Vtechcode/ESP32S3_A7672S/Images/schematic_a7672s.jpg

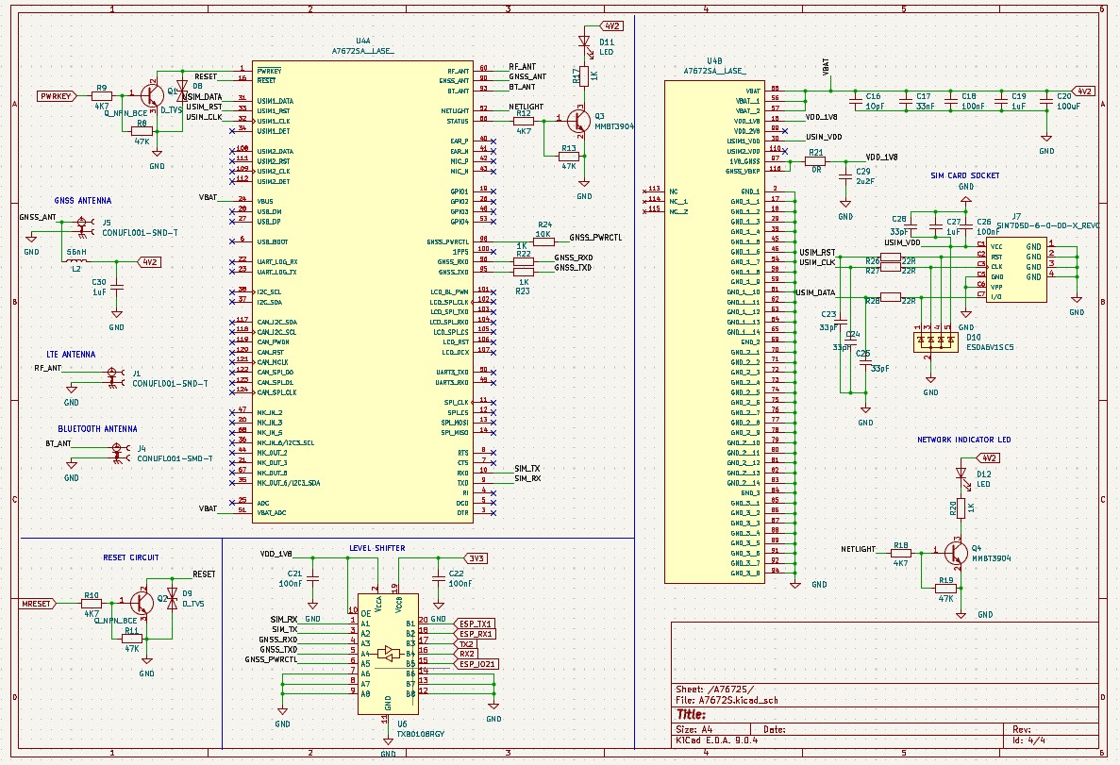
Images/schematic_a7672s.jpg
