Vtechcode/ESP32S3_A7672S/Images/schematic_esp32s3.jpg

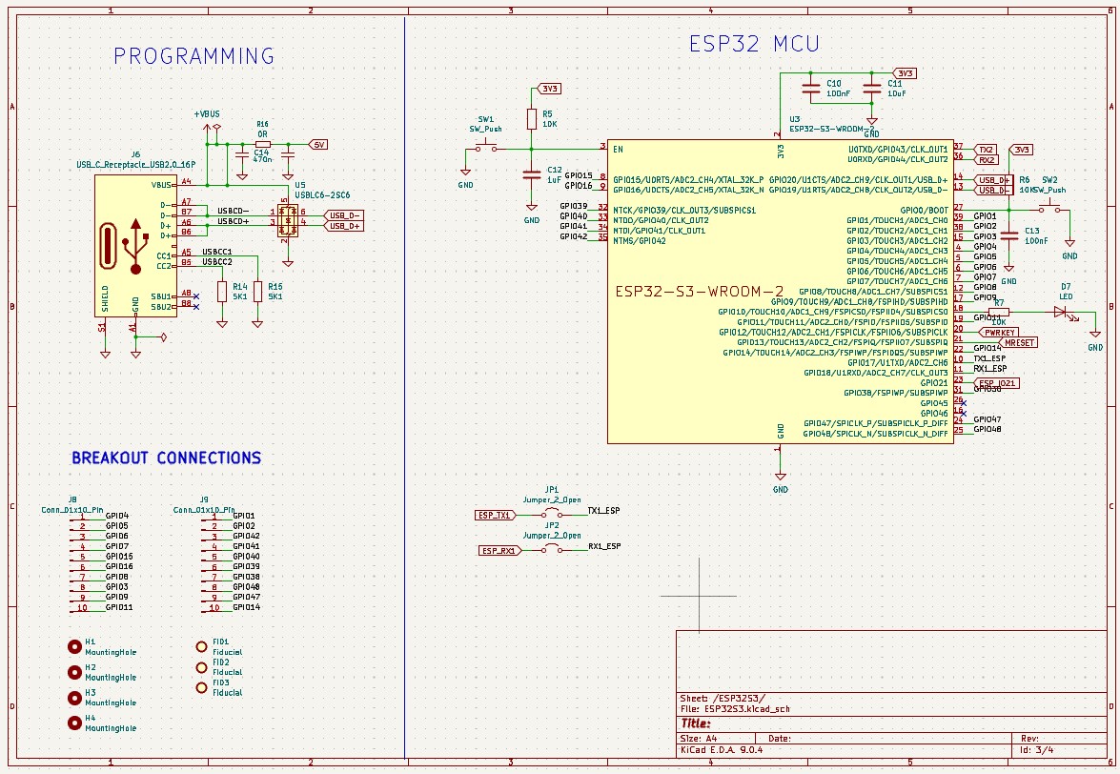
Images/schematic_esp32s3.jpg
