Vtechcode/ESP32S3_A7672S/Images/3d2.jpg

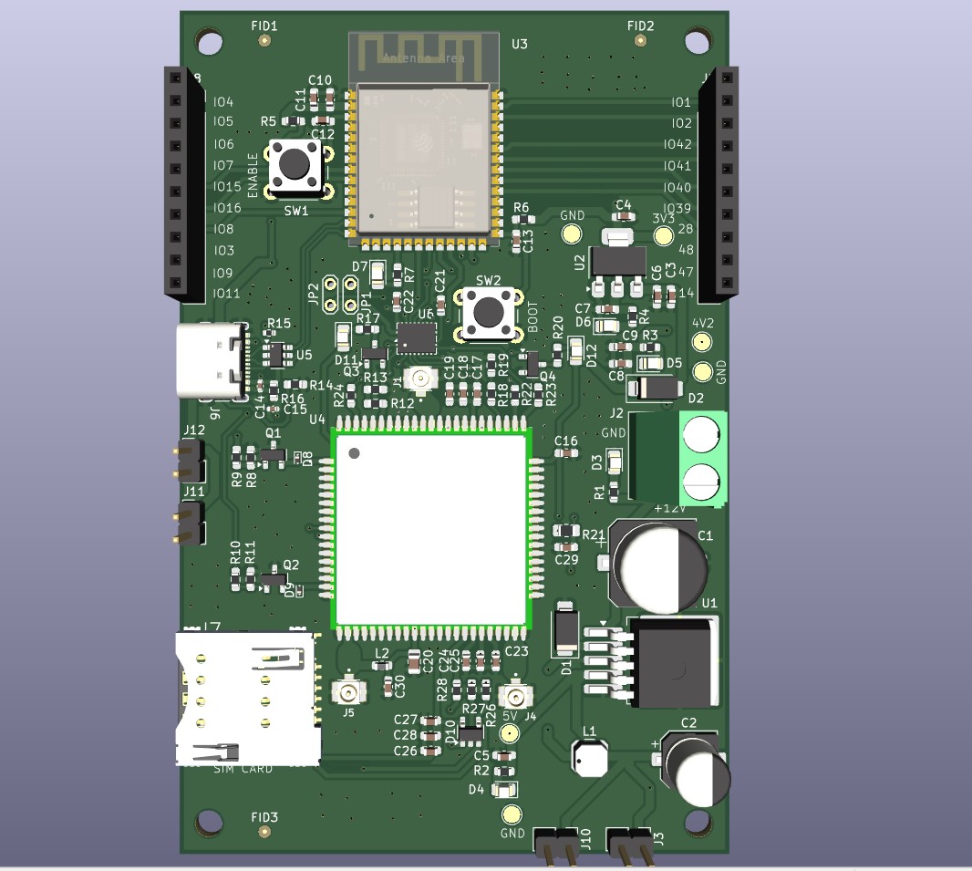
Images/3d2.jpg
