Vtechcode/ESP32S3_A7672S/Images/3d3.jpg

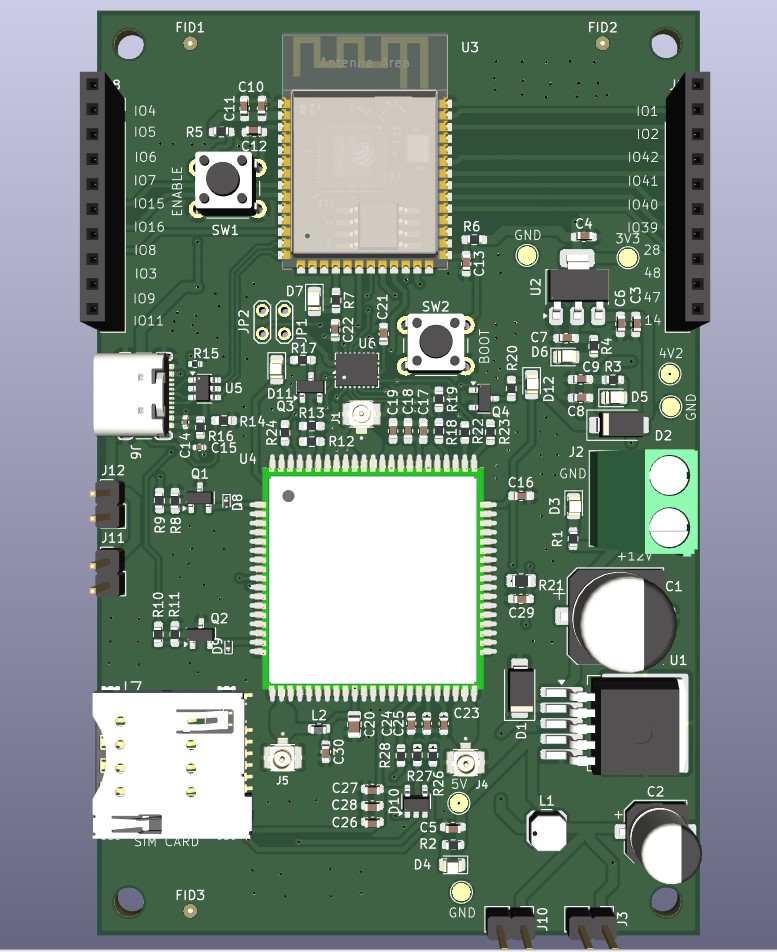
Images/3d3.jpg
