Vtechcode/ESP32S3_A7672S/Images/3D.jpg

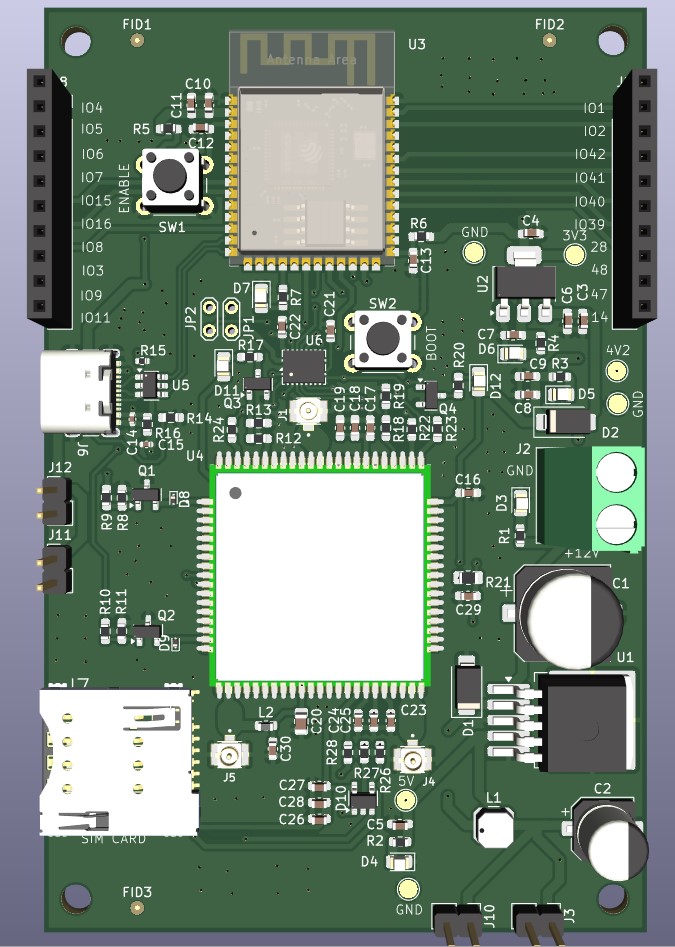
Images/3D.jpg
