Vtechcode/ESP32S3_A7672S/Images/layout.jpg

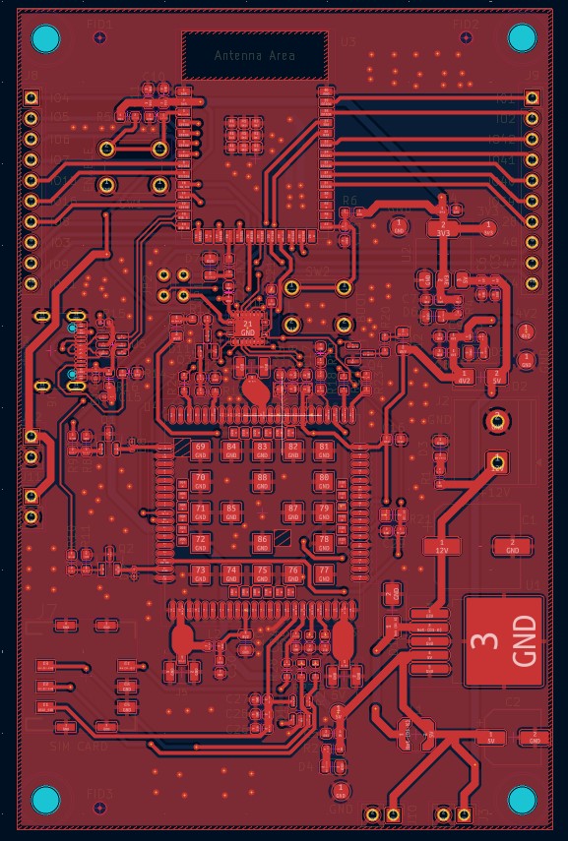
Images/layout.jpg
