Vtechcode/ESP32S3_A7672S/Images/schematic_power.jpg

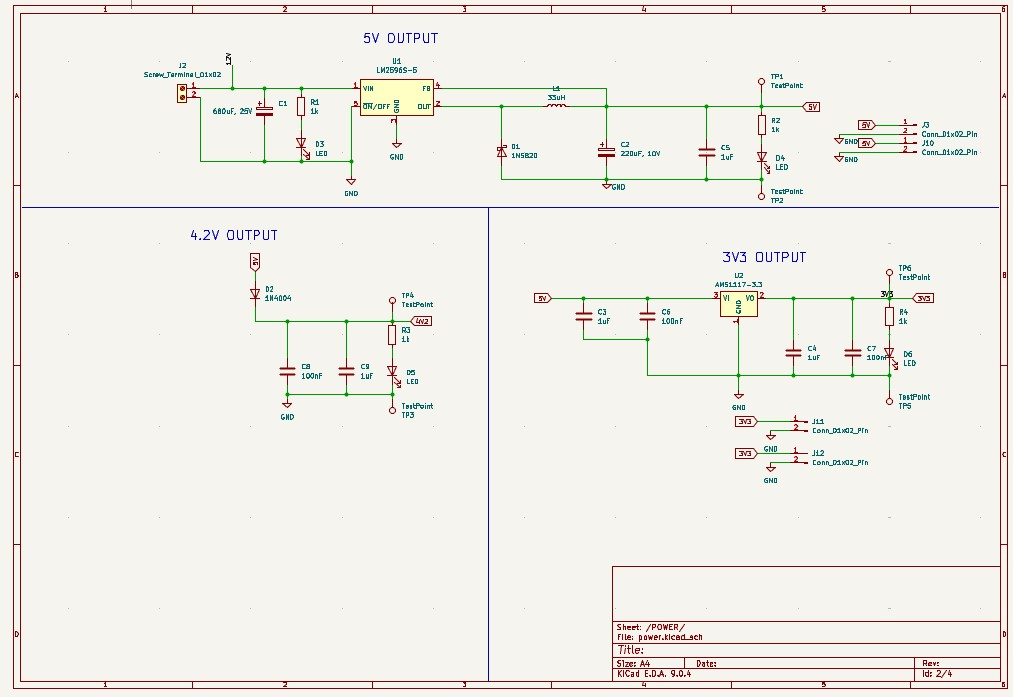
Images/schematic_power.jpg
