Vtechcode/ESP32S3_A7672S/manufacturing_files/ESP32S3-A7672S.csv

Reference | Qty | Value | DNP | Exclude from BOM | Exclude from Board | Footprint | Datasheet | Check_prices | Distributer | LCSC number | Availability
C1 | 1 | 680uF, 25V |  |  |  | Capacitor_SMD:CP_Elec_10x7.7 | ~ |  | https://www.digikey.com/en/products/detail/panasonic-industry/EEE-FN1E681UP/11657034 | C494831
C2 | 1 | 220uF, 10V |  |  |  | Capacitor_SMD:CP_Elec_6.3x7.7 | ~ |  | https://www.digikey.com/en/products/detail/panasonic-industry/EEE-1AA221XP/766038 | C336207
C3,C4,C5,C9,C12,C19 | 6 | 1uF |  |  |  | Capacitor_SMD:C_0603_1608Metric_Pad1.08x0.95mm_HandSolder | ~ |  | https://www.digikey.com/en/products/detail/samsung-electro-mechanics/CL10B105KA8NNNC/3886842 | C29936
C6,C7,C8,C10,C13,C18 | 6 | 100nF |  |  |  | Capacitor_SMD:C_0603_1608Metric_Pad1.08x0.95mm_HandSolder | ~ |  | https://www.digikey.com/en/products/detail/samsung-electro-mechanics/CL10E104KC8VPNC/20498486 | C16194197
C11 | 1 | 10uF |  |  |  | Capacitor_SMD:C_0603_1608Metric_Pad1.08x0.95mm_HandSolder | ~ |  | https://www.digikey.com/en/products/detail/murata-electronics/GRM188R6YA106MA73D/5877411 | C194427
C14,C15 | 2 | 470n |  |  |  | Capacitor_SMD:C_0402_1005Metric | ~ |  | https://eu.mouser.com/ProductDetail/Samsung-Electro-Mechanics/CL05A474KQ5NNND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 | C364319
C16 | 1 | 10pF |  |  |  | Capacitor_SMD:C_0603_1608Metric_Pad1.08x0.95mm_HandSolder | ~ |  | https://www.digikey.com/en/products/detail/kemet/C0603C100J5GACTU/411051 | C2167326
C17 | 1 | 33nF |  |  |  | Capacitor_SMD:C_0603_1608Metric_Pad1.08x0.95mm_HandSolder | ~ |  | https://www.digikey.com/en/products/detail/samsung-electro-mechanics/CL10B333KC8WPNC/20498521 | C16194260
C20 | 1 | 100uF |  |  |  | Capacitor_SMD:C_0805_2012Metric | ~ |  | https://www.digikey.com/en/products/detail/murata-electronics/GRM21BR60J107ME15L/6155751 | C141660
C21,C22,C26 | 3 | 100nF |  |  |  | Capacitor_SMD:C_0603_1608Metric | ~ |  | https://www.digikey.com/en/products/detail/samsung-electro-mechanics/CL10E104KC8VPNC/20498486 | C16194197
C23,C24,C25,C28 | 4 | 33pF |  |  |  | Capacitor_SMD:C_0603_1608Metric | ~ |  | https://www.digikey.com/en/products/detail/samsung-electro-mechanics/CL10C330JB8NNNC/3886728 | C1663
C27,C30 | 2 | 1uF |  |  |  | Capacitor_SMD:C_0603_1608Metric | ~ |  | https://www.digikey.com/en/products/detail/samsung-electro-mechanics/CL10B105KA8NNNC/3886842 | C29936
C29 | 1 | 2u2F |  |  |  | Capacitor_SMD:C_0603_1608Metric_Pad1.08x0.95mm_HandSolder | ~ |  | https://www.digikey.com/en/products/detail/samsung-electro-mechanics/CL10A225KO8NNNC/3886698 | C23630
D1 | 1 | 1N5820 |  |  |  | Diode_SMD:D_SMA | http://www.vishay.com/docs/88526/1n5820.pdf |  | https://eu.mouser.com/ProductDetail/Microchip-Technology/1N5820?qs=w%2Fv1CP2dgqqgWjSAo9oFwA%3D%3D | C95400
D2 | 1 | 1N4004 |  |  |  | Diode_SMD:D_SMA | http://www.vishay.com/docs/88503/1n4001.pdf |  | https://eu.mouser.com/ProductDetail/Rectron/FM4004-W?qs=Iw9Ubr57Px3IHNH1bE4l9w%3D%3D | C727080
D3,D4,D5,D6 | 4 | LED |  |  |  | LED_SMD:LED_0805_2012Metric | ~ |  | https://www.digikey.com/en/products/detail/kingbright/APT2012SURCK/1747532 | C5875730
D7,D11,D12 | 3 | LED |  |  |  | LED_SMD:LED_0805_2012Metric_Pad1.15x1.40mm_HandSolder | ~ |  | https://www.digikey.com/en/products/detail/kingbright/APT2012LVBC-D/5177439 | C5879383
D8,D9 | 2 | D_TVS |  |  |  | Diode_SMD:D_SOD-923 | ~ |  | https://www.digikey.com/en/products/detail/onsemi/ESD9X5-0ST5G/1476616 | C87910
D10 | 1 | ESDA6V1SC5 |  |  |  | Package_TO_SOT_SMD:SOT-23-5 | https://www.st.com/resource/en/datasheet/esda5v3sc6.pdf |  | https://www.digikey.com/en/products/detail/stmicroelectronics/ESDA6V1SC5/1037990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 | C2935146
FID1,FID2,FID3 | 3 | Fiducial |  | Excluded from BOM |  | Fiducial:Fiducial_0.5mm_Mask1.5mm | ~
H1,H2,H3,H4 | 4 | MountingHole |  | Excluded from BOM |  | MountingHole:MountingHole_3.2mm_M3 | ~
J1,J4,J5 | 3 | CONUFL001-SMD-T |  |  |  | UFL:LINX_CONUFL001-SMD-T |  | https://www.snapeda.com/parts/CONUFL001-SMD/TE+Connectivity/view-part/?ref=eda | https://www.digikey.com/en/products/detail/te-connectivity-linx/CONUFL001-SMD-T/7427732 | C22418213 | In Stock
J2 | 1 | Screw_Terminal_01x02 |  |  |  | TerminalBlock_Phoenix:TerminalBlock_Phoenix_MKDS-1,5-2-5.08_1x02_P5.08mm_Horizontal | ~ |  |  | C5183929
J3,J10,J11,J12 | 4 | Conn_01x02_Pin |  | Excluded from BOM |  | Connector_PinHeader_2.54mm:PinHeader_1x02_P2.54mm_Vertical | ~
J6 | 1 | USB_C_Receptacle_USB2.0_16P |  |  |  | Connector_USB:USB_C_Receptacle_GCT_USB4105-xx-A_16P_TopMnt_Horizontal | https://www.usb.org/sites/default/files/documents/usb_type-c.zip |  | https://www.digikey.com/en/products/detail/same-sky-formerly-cui-devices/UJ20-C-H-G-SMT-1-P16-TR/24818576 | C45082766
J7 | 1 | SIM7050-6-0-00-X_REVC |  |  |  | sim7050:GCT_SIM7050-6-0-00-X_REVC |  | https://www.snapeda.com/parts/SIM7050-6-0-00-A/Global+Connector+Technology/view-part/?ref=eda | https://www.digikey.com/en/products/detail/gct/SIM7050-6-0-00-A/9859623 | C7363806 | In Stock
J8,J9 | 2 | Conn_01x10_Pin |  | Excluded from BOM |  | Connector_PinSocket_2.54mm:PinSocket_1x10_P2.54mm_Vertical | ~
JP1,JP2 | 2 | Jumper_2_Open |  | Excluded from BOM |  | TestPoint:TestPoint_2Pads_Pitch2.54mm_Drill0.8mm | ~
L1 | 1 | 33uH |  |  |  | Inductor_SMD:L_Coilcraft_LPS4018 | ~ |  | https://eu.mouser.com/en/ProductDetail/Coilcraft/LPS4018-333MRC?qs=QQJxVsr8EGZpg9FhYnz6eA%3D%3D | C5350136
L2 | 1 | 56nH |  |  |  | Inductor_SMD:L_0603_1608Metric | ~ |  | https://www.digikey.com/en/products/detail/bourns-inc/CE0603M-56NH/28968971 | C98079
Q1,Q2 | 2 | Q_NPN_BCE |  |  |  | Package_TO_SOT_SMD:SOT-23 | ~ |  | https://www.digikey.com/en/products/detail/onsemi/BC847CLT3G/1476015 | C513268
Q3,Q4 | 2 | MMBT3904 |  |  |  | Package_TO_SOT_SMD:SOT-23 | https://www.onsemi.com/pdf/datasheet/pzt3904-d.pdf |  | https://www.digikey.com/en/products/detail/onsemi/MMBT3904LT1G/919601 | C81464
R1,R2,R3,R4 | 4 | 1k |  |  |  | Resistor_SMD:R_0603_1608Metric | ~ |  | https://eu.mouser.com/ProductDetail/YAGEO/RT0603BRC071KL?qs=FVx2PiaBrRX2drlDnD5t4A%3D%3D | C860716
R5,R6,R7,R24 | 4 | 10K |  |  |  | Resistor_SMD:R_0603_1608Metric_Pad0.98x0.95mm_HandSolder | ~ |  | https://www.digikey.com/en/products/detail/stackpole-electronics-inc/RMCF0603FT10K0/1761235 | C2479067
R8,R11,R13,R19 | 4 | 47K |  |  |  | Resistor_SMD:R_0603_1608Metric_Pad0.98x0.95mm_HandSolder | ~ |  | https://www.digikey.com/en/products/detail/yageo/RC0603FR-0747KL/727253 | C105579
R9,R10,R12,R18 | 4 | 4K7 |  |  |  | Resistor_SMD:R_0603_1608Metric_Pad0.98x0.95mm_HandSolder | ~ |  | https://www.digikey.com/en/products/detail/yageo/RC0603FR-074K7L/727212 | C99782
R14 | 1 | 5K1 |  |  |  | Resistor_SMD:R_0603_1608Metric_Pad0.98x0.95mm_HandSolder | ~ |  | https://www.digikey.com/en/products/detail/panasonic-industry/ERJ-3EKF5101V/1746427 | C123727
R15 | 1 | 5K1 |  |  |  | Resistor_SMD:R_0402_1005Metric | ~ |  | https://www.digikey.com/en/products/detail/panasonic-industry/ERJ-3EKF5101V/1746427 | C123727
R16 | 1 | 0R |  |  |  | Resistor_SMD:R_0603_1608Metric | ~ |  | https://eu.mouser.com/ProductDetail/YAGEO/RC0603FR-070RL?qs=0yPvnVz5%2FmpDQv43TwvCfw%3D%3D | C100044
R17,R20,R23 | 3 | 1K |  |  |  | Resistor_SMD:R_0603_1608Metric_Pad0.98x0.95mm_HandSolder | ~ |  | https://eu.mouser.com/ProductDetail/YAGEO/RT0603BRC071KL?qs=FVx2PiaBrRX2drlDnD5t4A%3D%3D | C860716
R21 | 1 | 0R |  |  |  | Resistor_SMD:R_0805_2012Metric_Pad1.20x1.40mm_HandSolder | ~ |  | https://www.digikey.com/en/products/detail/yageo/RC0805FR-070RL/2827620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 | C100045
R22 | 1 | 1K |  |  |  | Resistor_SMD:R_0603_1608Metric | ~ |  | https://www.digikey.com/en/products/detail/bourns-inc/CE0603M-56NH/28968971 | C98079
R26,R27,R28 | 3 | 22R |  |  |  | Resistor_SMD:R_0603_1608Metric | ~ |  | https://www.digikey.com/en/products/detail/stackpole-electronics-inc/RMCF0603FT22R0/1760726 | C2479410
SW1,SW2 | 2 | SW_Push |  |  |  | Button_Switch_THT:SW_PUSH_6mm | ~ |  | https://www.digikey.com/en/products/detail/te-connectivity-alcoswitch-switches/1825910-6/1632536 | C428628
TP1,TP2,TP3,TP4,TP5,TP6 | 6 | TestPoint |  |  |  | TestPoint:TestPoint_Pad_D2.0mm | ~
U1 | 1 | LM2596S-5 |  |  |  | Package_TO_SOT_SMD:TO-263-5_TabPin3 | http://www.ti.com/lit/ds/symlink/lm2596.pdf |  | https://eu.mouser.com/ProductDetail/Texas-Instruments/LM2596S-5.0-NOPB?qs=X1J7HmVL2ZHVjCOmW%252BYINA%3D%3D | C116713
U2 | 1 | AMS1117-3.3 |  |  |  | Package_TO_SOT_SMD:SOT-223-3_TabPin2 | http://www.advanced-monolithic.com/pdf/ds1117.pdf |  | https://eu.mouser.com/ProductDetail/Texas-Instruments/LM1117MPX-3.3-NOPB?qs=X1J7HmVL2ZHRbBIxXi4utg%3D%3D | C9662
U3 | 1 | ESP32-S3-WROOM-2 |  |  |  | PCM_Espressif:ESP32-S3-WROOM-2 | https://www.espressif.com/sites/default/files/documentation/esp32-s3-wroom-2_datasheet_en.pdf |  | https://eu.mouser.com/en/ProductDetail/Espressif-Systems/ESP32-S3-WROOM-2-N32R16V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 | C42417293
U4 | 1 | A7672SA__LASE_ |  |  |  | A7672s:XCVR_A7672SA__LASE_ |  |  | https://www.digikey.com/en/products/detail/simcom-wireless-solutions-limited/A7672E-FASE/15841437 | C5370391
U5 | 1 | USBLC6-2SC6 |  |  |  | Package_TO_SOT_SMD:SOT-23-6 | https://www.st.com/resource/en/datasheet/usblc6-2.pdf |  | https://eu.mouser.com/ProductDetail/STMicroelectronics/USBLC6-2SC6?qs=po45yt2pPpu%2FhNIlwQdTlg%3D%3D | C7519
U6 | 1 | TXB0108RGY |  |  |  | Package_DFN_QFN:Texas_RGY_R-PVQFN-N20_EP2.05x3.05mm | http://www.ti.com/lit/ds/symlink/txb0108.pdf |  | https://eu.mouser.com/en/ProductDetail/Texas-Instruments/TXB0108RGYR?qs=oFXvjAmG9EjlwpBG6jCg6w%3D%3D | C194701
