Vtechcode/ESP32S3_A7672S/ESP32S3-A7672S/ESP32S3-A7672S.kicad_pcb

## KiCad design ESP32S3-A7672S/ESP32S3-A7672S.kicad_pcb (2026-09-28)

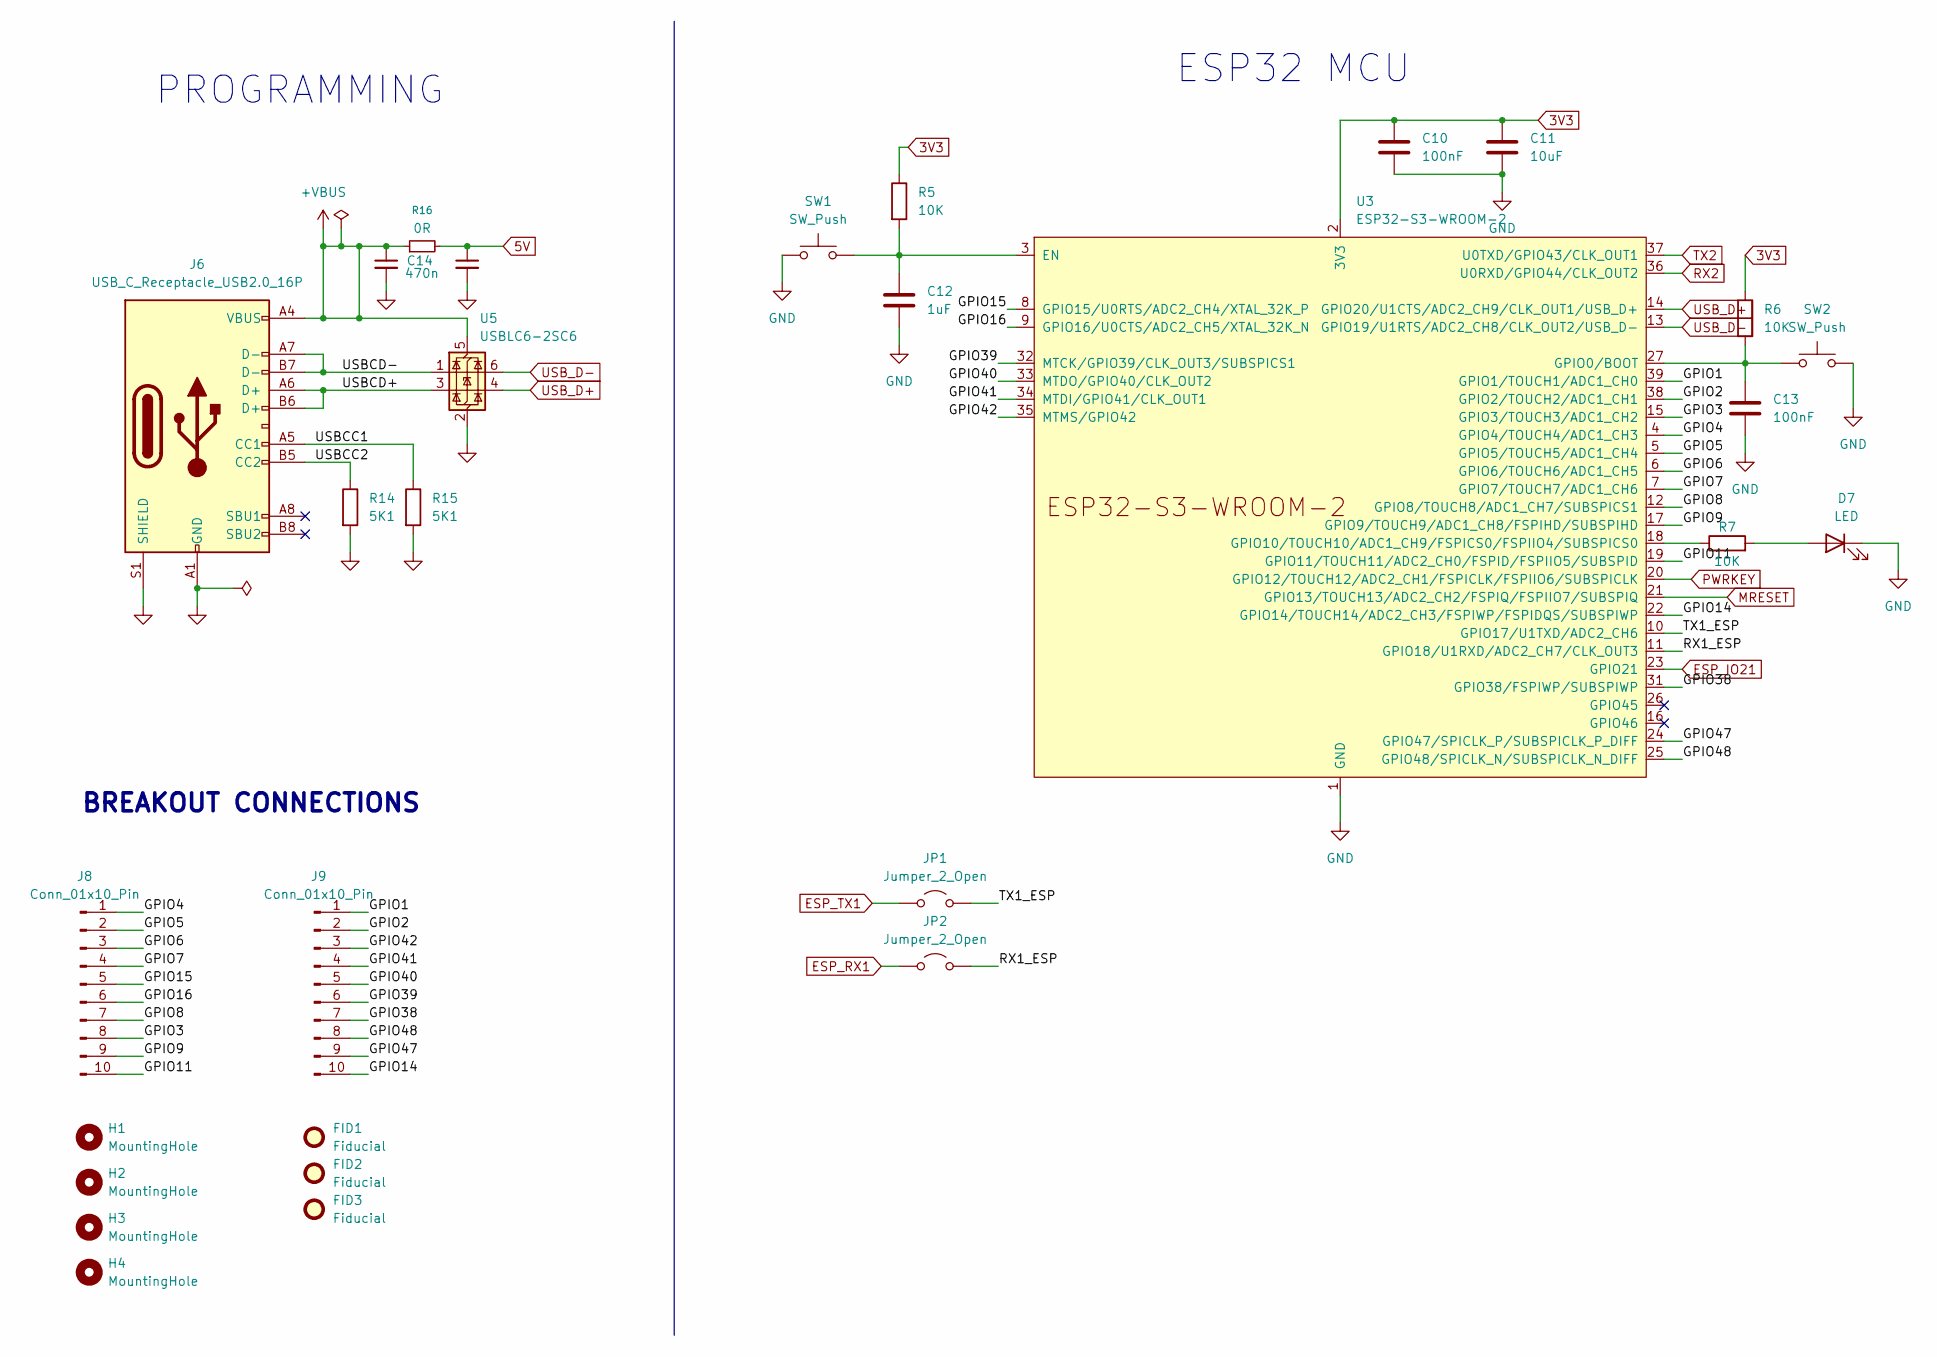
[picture p8: schematic ESP32S3.kicad_sch]

Parts:
C10, C13: 100nF; C_0603_1608Metric_Pad1.08x0.95mm_HandSolder; LCSC number C16194197
C11: 10uF; C_0603_1608Metric_Pad1.08x0.95mm_HandSolder; LCSC number C194427
C12: 1uF; C_0603_1608Metric_Pad1.08x0.95mm_HandSolder; LCSC number C29936
C14, C15: 470n; C_0402_1005Metric; LCSC number C364319
D7: LED; LED_0805_2012Metric_Pad1.15x1.40mm_HandSolder; LCSC number C5879383
FID1, FID2, FID3: Fiducial; Fiducial_0.5mm_Mask1.5mm
H1, H2, H3, H4: MountingHole; MountingHole_3.2mm_M3
J6: USB_C_Receptacle_USB2.0_16P; USB_C_Receptacle_GCT_USB4105-xx-A_16P_TopMnt_Horizontal; LCSC number C45082766
J8, J9: Conn_01x10_Pin; PinSocket_1x10_P2.54mm_Vertical
JP1, JP2: Jumper_2_Open; TestPoint_2Pads_Pitch2.54mm_Drill0.8mm
R5, R6, R7: 10K; R_0603_1608Metric_Pad0.98x0.95mm_HandSolder; LCSC number C2479067
R14: 5K1; R_0603_1608Metric_Pad0.98x0.95mm_HandSolder; LCSC number C123727
R15: 5K1; R_0402_1005Metric; LCSC number C123727
R16: 0R; R_0603_1608Metric; LCSC number C100044
SW1, SW2: SW_Push; SW_PUSH_6mm; LCSC number C428628
U3: ESP32-S3-WROOM-2; LCSC number C42417293
U5: USBLC6-2SC6; SOT-23-6; LCSC number C7519

Connections:
3V3: C10.1, C11.1, R5.1, R6.1, U3.2 (3V3); also elsewhere on the board
5V: C15.1, R16.2; also elsewhere on the board
+VBUS: C14.1, J6.A4 (VBUS), J6.A9 (VBUS), J6.B4 (VBUS), J6.B9 (VBUS), R16.1, U5.5 (VBUS)
/ESP32S3/GPIO1: J9.1, U3.39 (GPIO1/TOUCH1/ADC1_CH0)
/ESP32S3/GPIO2: J9.2, U3.38 (GPIO2/TOUCH2/ADC1_CH1)
/ESP32S3/GPIO3: J8.8, U3.15 (GPIO3/TOUCH3/ADC1_CH2)
/ESP32S3/GPIO4: J8.1, U3.4 (GPIO4/TOUCH4/ADC1_CH3)
/ESP32S3/GPIO5: J8.2, U3.5 (GPIO5/TOUCH5/ADC1_CH4)
/ESP32S3/GPIO6: J8.3, U3.6 (GPIO6/TOUCH6/ADC1_CH5)
/ESP32S3/GPIO7: J8.4, U3.7 (GPIO7/TOUCH7/ADC1_CH6)
/ESP32S3/GPIO8: J8.7, U3.12 (GPIO8/TOUCH8/ADC1_CH7/SUBSPICS1)
/ESP32S3/GPIO9: J8.9, U3.17 (GPIO9/TOUCH9/ADC1_CH8/FSPIHD/SUBSPIHD)
/ESP32S3/GPIO11: J8.10, U3.19 (GPIO11/TOUCH11/ADC2_CH0/FSPID/FSPIIO5/S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)
/ESP32S3/GPIO14: J9.10, U3.22 (GPIO14/TOUCH14/ADC2_CH3/FSPIWP/FSPIDQS/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)
/ESP32S3/GPIO15: J8.5, U3.8 (GPIO15/U0RTS/ADC2_CH4/XTAL_32K_P)
/ESP32S3/GPIO16: J8.6, U3.9 (GPIO16/U0CTS/ADC2_CH5/XTAL_32K_N)
/ESP32S3/GPIO38: J9.7, U3.31 (GPIO38/FSPIWP/SUBSPIWP)
/ESP32S3/GPIO39: J9.6, U3.32 (MTCK/GPIO39/CLK_OUT3/SUBSPICS1)
/ESP32S3/GPIO40: J9.5, U3.33 (MTDO/GPIO40/CLK_OUT2)
/ESP32S3/GPIO41: J9.4, U3.34 (MTDI/GPIO41/CLK_OUT1)
/ESP32S3/GPIO42: J9.3, U3.35 (MTMS/GPIO42)
/ESP32S3/GPIO47: J9.9, U3.24 (GPIO47/SPICLK_P/SUBSPICLK_P_DIFF)
/ESP32S3/GPIO48: J9.8, U3.25 (GPIO48/SPICLK_N/SUBSPICLK_N_DIFF)
/ESP32S3/RX1_ESP: JP2.2 (B), U3.11 (GPIO18/U1RXD/ADC2_CH7/CLK_OUT3)
/ESP32S3/TX1_ESP: JP1.2 (B), U3.10 (GPIO17/U1TXD/ADC2_CH6)
/ESP32S3/USBCC1: J6.A5 (CC1), R15.1
/ESP32S3/USBCC2: J6.B5 (CC2), R14.1
/ESP32S3/USBCD+: J6.A6 (D+), J6.B6 (D+), U5.3 (I/O2)
/ESP32S3/USBCD-: J6.A7 (D-), J6.B7 (D-), U5.1 (I/O1)
ESP_IO21: U3.23 (GPIO21); also elsewhere on the board
ESP_RX1: JP2.1 (A); also elsewhere on the board
ESP_TX1: JP1.1 (A); also elsewhere on the board
GND: C10.2, C11.2, C12.2, C13.2, C14.2, C15.2, D7.1 (K), J6.A1 (GND), J6.A12 (GND), J6.B1 (GND), J6.B12 (GND), J6.S1 (SHIELD), R14.2, R15.2, SW1.1, SW2.2, U3.1 (GND), U3.40 (GND), U3.41 (GND), U5.2 (GND); also elsewhere on the board
MRESET: U3.21 (GPIO13/TOUCH13/ADC2_CH2/FSPIQ/FSPIIO7/S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); also elsewhere on the board
unnamed: D7.2 (A), R7.2
unnamed: C12.1, R5.2, SW1.2, U3.3 (EN)
unnamed: C13.1, R6.2, SW2.1, U3.27 (GPIO0/BOOT)
unnamed: R7.1, U3.18 (GPIO10/TOUCH10/ADC1_CH9/FSPICS0/FSPIIO4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)
PWRKEY: U3.20 (GPIO12/TOUCH12/ADC2_CH1/FSPICLK/FSPIIO6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); also elsewhere on the board
RX2: U3.36 (U0RXD/GPIO44/CLK_OUT2); also elsewhere on the board
TX2: U3.37 (U0TXD/GPIO43/CLK_OUT1); also elsewhere on the board
USB_D+: U3.14 (GPIO20/U1CTS/ADC2_CH9/CLK_OUT1/USB_D+), U5.4 (I/O2)
USB_D-: U3.13 (GPIO19/U1RTS/ADC2_CH8/CLK_OUT2/USB_D-), U5.6 (I/O1)

Notes on the sheet:
ESP32 MCU
BREAKOUT CONNECTIONS
PROGRAMMING

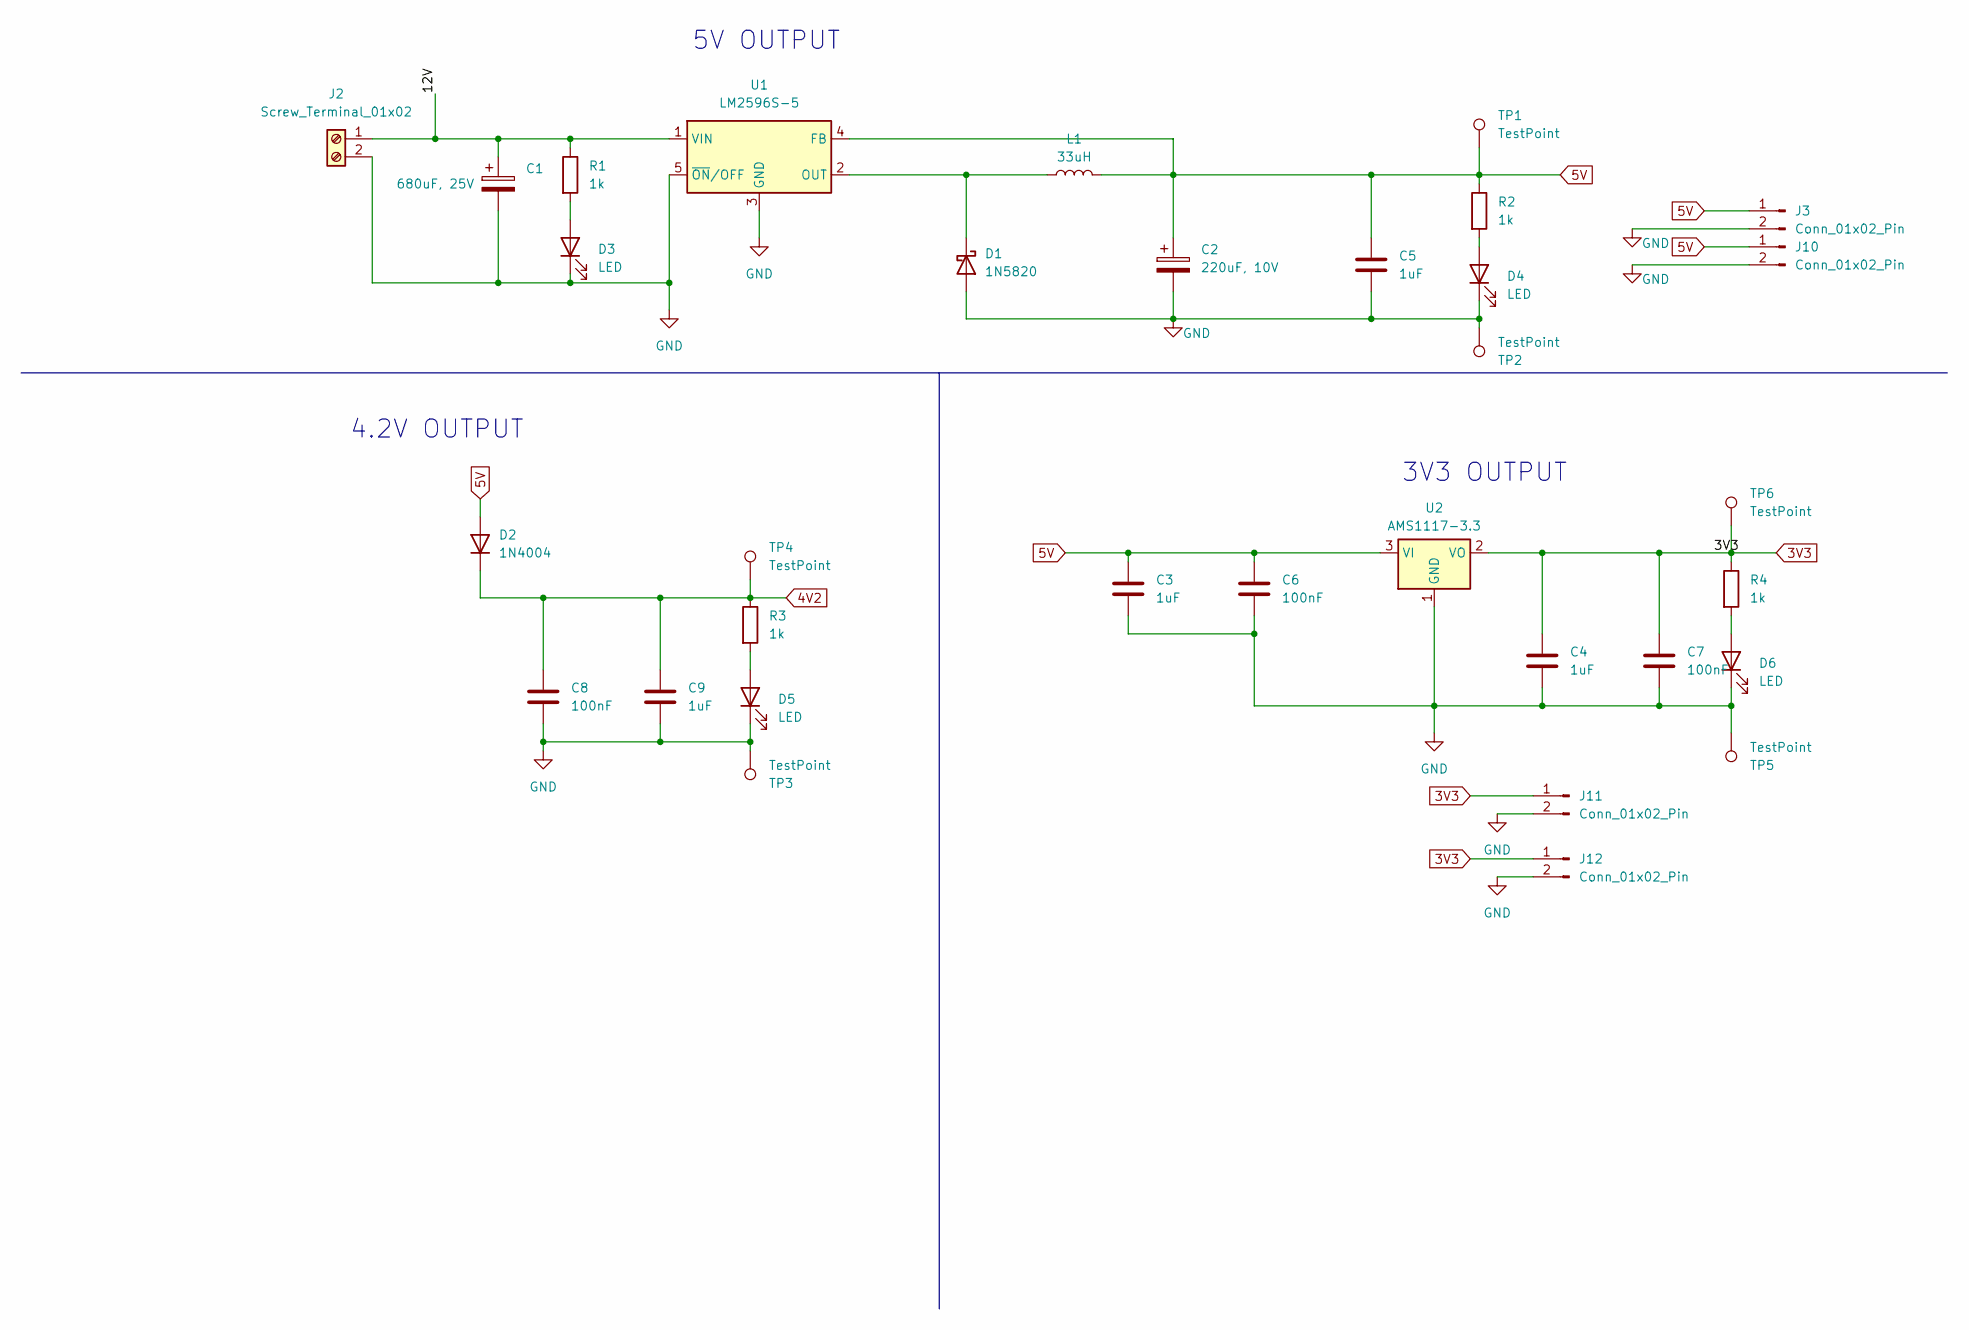
[picture p9: schematic power.kicad_sch]

Parts:
C1: 680uF, 25V; CP_Elec_10x7.7; LCSC number C494831
C2: 220uF, 10V; CP_Elec_6.3x7.7; LCSC number C336207
C3, C4, C5, C9: 1uF; C_0603_1608Metric_Pad1.08x0.95mm_HandSolder; LCSC number C29936
C6, C7, C8: 100nF; C_0603_1608Metric_Pad1.08x0.95mm_HandSolder; LCSC number C16194197
D1: 1N5820; D_SMA; LCSC number C95400
D2: 1N4004; D_SMA; LCSC number C727080
D3, D4, D5, D6: LED; LED_0805_2012Metric; LCSC number C5875730
J2: Screw_Terminal_01x02; TerminalBlock_Phoenix_MKDS-1,5-2-5.08_1x02_P5.08mm_Horizont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; LCSC number C5183929
J3, J10, J11, J12: Conn_01x02_Pin; PinHeader_1x02_P2.54mm_Vertical
L1: 33uH; L_Coilcraft_LPS4018; LCSC number C5350136
R1, R2, R3, R4: 1k; R_0603_1608Metric; LCSC number C860716
TP1, TP2, TP3, TP4, TP5, TP6: TestPoint; TestPoint_Pad_D2.0mm
U1: LM2596S-5; TO-263-5_TabPin3; LCSC number C116713
U2: AMS1117-3.3; SOT-223-3_TabPin2; LCSC number C9662

Connections:
3V3: C4.1, C7.1, J11.1, J12.1, R4.1, TP6.1, U2.2 (VO); also elsewhere on the board
4V2: C8.1, C9.1, D2.1 (K), R3.1, TP4.1; also elsewhere on the board
5V: C2.1, C3.1, C5.1, C6.1, D2.2 (A), J3.1, J10.1, L1.2, R2.1, TP1.1, U1.4 (FB), U2.3 (VI); also elsewhere on the board
/POWER/12V: C1.1, J2.1, R1.1, U1.1 (VIN)
GND: C1.2, C2.2, C3.2, C4.2, C5.2, C6.2, C7.2, C8.2, C9.2, D1.2 (A), D3.1 (K), D4.1 (K), D5.1 (K), D6.1 (K), J2.2, J3.2, J10.2, J11.2, J12.2, TP2.1, TP3.1, TP5.1, U1.3 (GND), U1.5 (~ON/OFF), U2.1 (GND); also elsewhere on the board
unnamed: D1.1 (K), L1.1, U1.2 (OUT)
unnamed: D3.2 (A), R1.2
unnamed: D4.2 (A), R2.2
unnamed: D5.2 (A), R3.2
unnamed: D6.2 (A), R4.2

Notes on the sheet:
3V3 OUTPUT
5V OUTPUT
4.2V OUTPUT

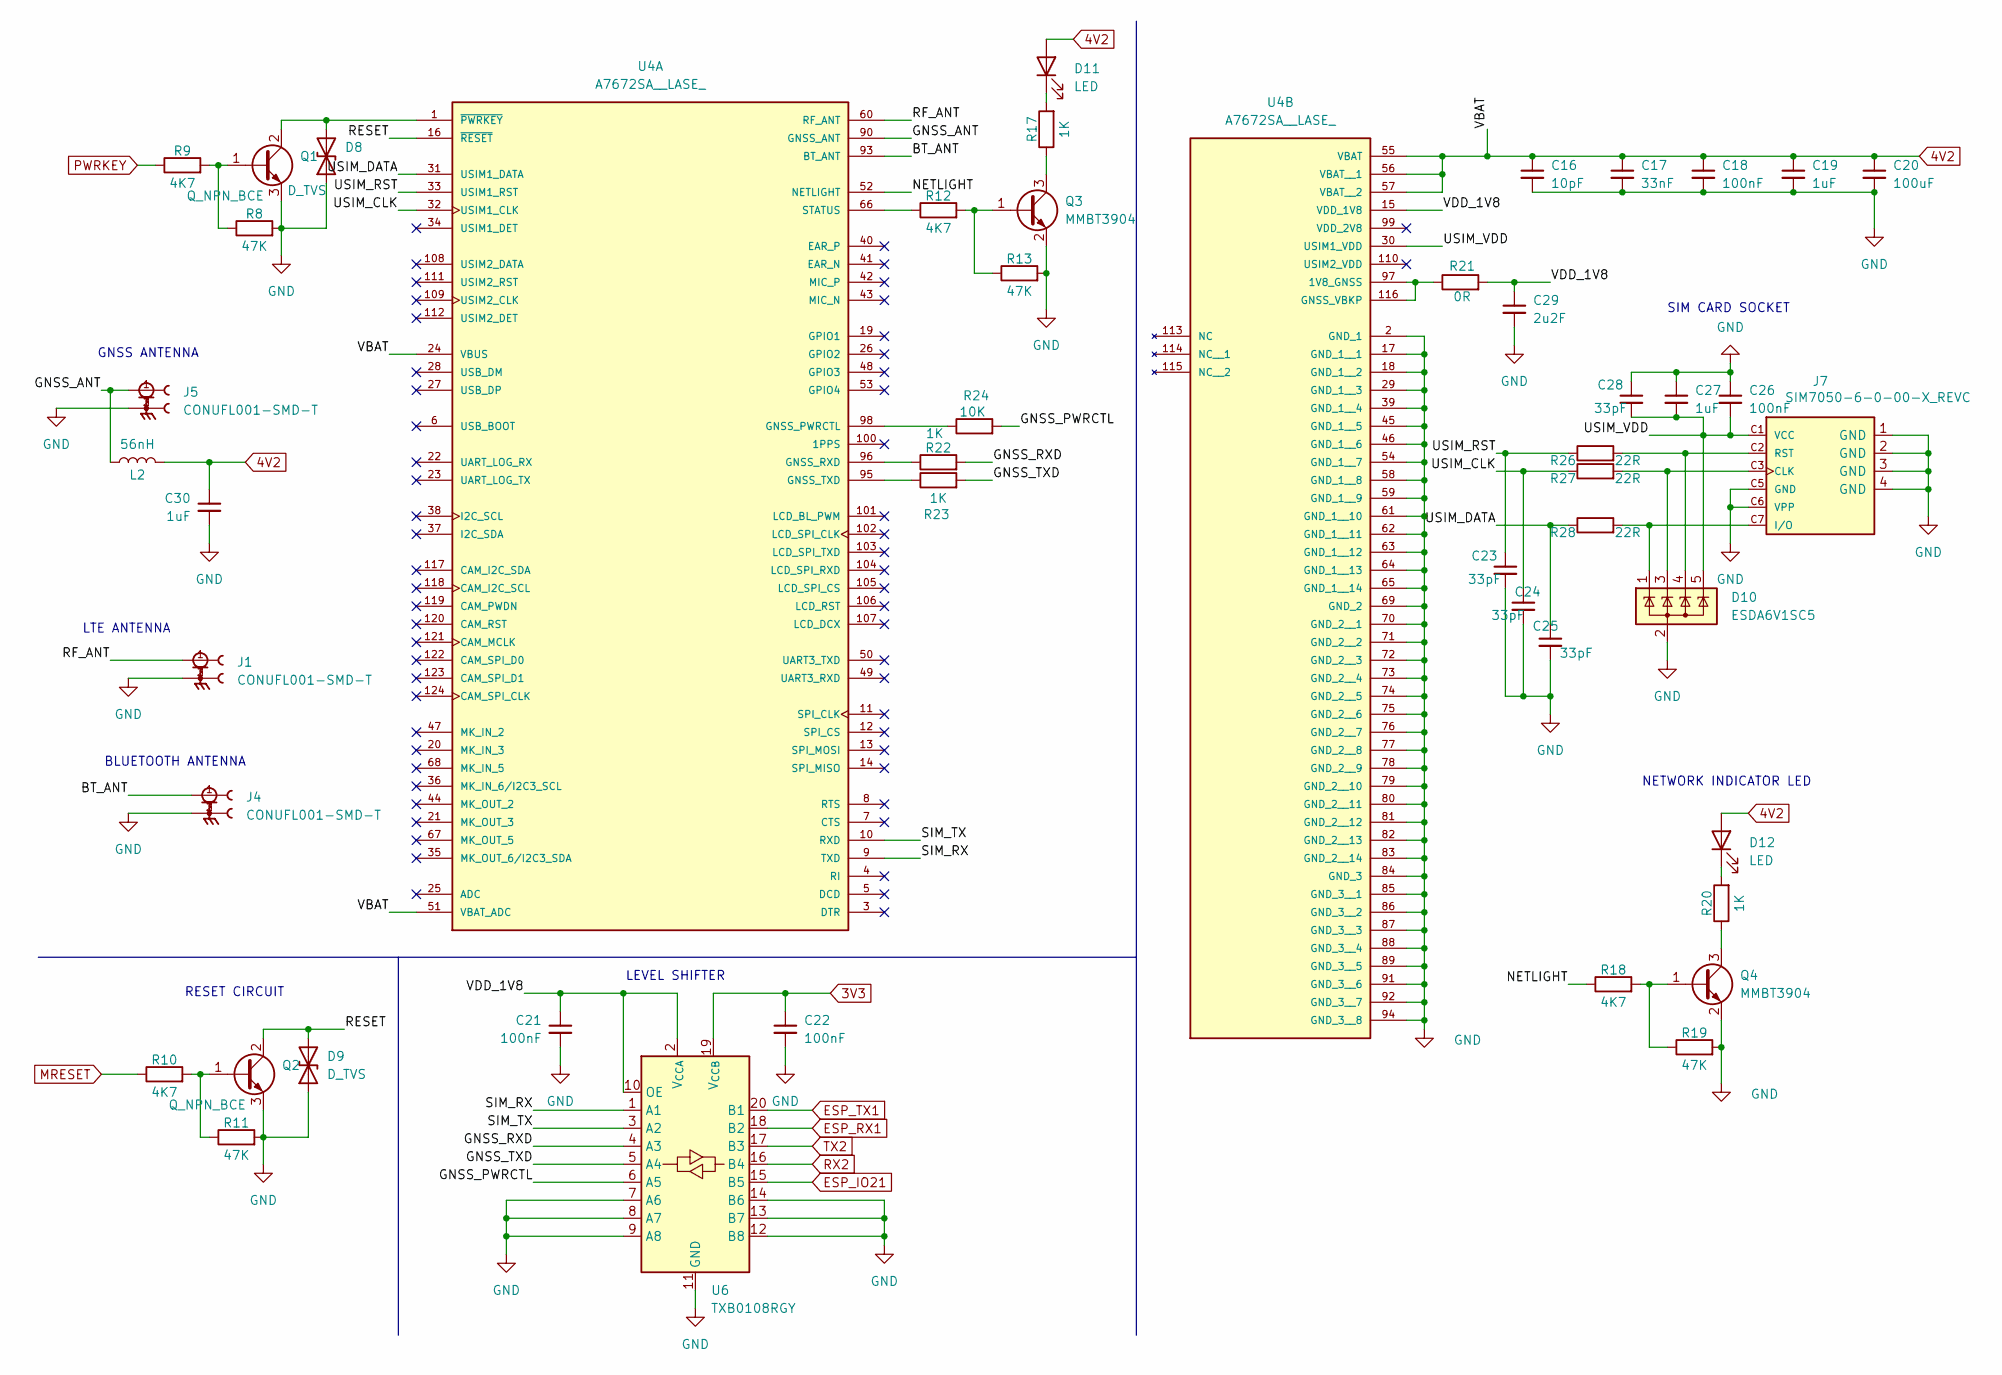
[picture p10: schematic A7672S.kicad_sch]

Parts:
C16: 10pF; C_0603_1608Metric_Pad1.08x0.95mm_HandSolder; LCSC number C2167326
C17: 33nF; C_0603_1608Metric_Pad1.08x0.95mm_HandSolder; LCSC number C16194260
C18: 100nF; C_0603_1608Metric_Pad1.08x0.95mm_HandSolder; LCSC number C16194197
C19: 1uF; C_0603_1608Metric_Pad1.08x0.95mm_HandSolder; LCSC number C29936
C20: 100uF; C_0805_2012Metric; LCSC number C141660
C21, C22, C26: 100nF; C_0603_1608Metric; LCSC number C16194197
C23, C24, C25, C28: 33pF; C_0603_1608Metric; LCSC number C1663
C27, C30: 1uF; C_0603_1608Metric; LCSC number C29936
C29: 2u2F; C_0603_1608Metric_Pad1.08x0.95mm_HandSolder; LCSC number C23630
D8, D9: D_TVS; D_SOD-923; LCSC number C87910
D10: ESDA6V1SC5; SOT-23-5; LCSC number C2935146
D11, D12: LED; LED_0805_2012Metric_Pad1.15x1.40mm_HandSolder; LCSC number C5879383
J1, J4, J5: CONUFL001-SMD-T; LINX_CONUFL001-SMD-T; LCSC number C22418213
J7: SIM7050-6-0-00-X_REVC; GCT_SIM7050-6-0-00-X_REVC; LCSC number C7363806
L2: 56nH; L_0603_1608Metric; LCSC number C98079
Q1, Q2: Q_NPN_BCE; SOT-23; LCSC number C513268
Q3, Q4: MMBT3904; SOT-23; LCSC number C81464
R8, R11, R13, R19: 47K; R_0603_1608Metric_Pad0.98x0.95mm_HandSolder; LCSC number C105579
R9, R10, R12, R18: 4K7; R_0603_1608Metric_Pad0.98x0.95mm_HandSolder; LCSC number C99782
R17, R20, R23: 1K; R_0603_1608Metric_Pad0.98x0.95mm_HandSolder; LCSC number C860716
R21: 0R; R_0805_2012Metric_Pad1.20x1.40mm_HandSolder; LCSC number C100045
R22: 1K; R_0603_1608Metric; LCSC number C98079
R24: 10K; R_0603_1608Metric_Pad0.98x0.95mm_HandSolder; LCSC number C2479067
R26, R27, R28: 22R; R_0603_1608Metric; LCSC number C2479410
U4: A7672SA__LASE_; XCVR_A7672SA__LASE_; PARTREV 1.03; LCSC number C5370391
U6: TXB0108RGY; Texas_RGY_R-PVQFN-N20_EP2.05x3.05mm; LCSC number C194701

Connections:
3V3: C22.1, U6.19 (V_{CCB}); also elsewhere on the board
4V2: C16.1, C17.1, C18.1, C19.1, C20.1, C30.1, D11.2 (A), D12.2 (A), L2.2, U4.24 (VBUS), U4.51 (VBAT_ADC), U4.55 (VBAT), U4.56 (VBAT__1), U4.57 (VBAT__2); also elsewhere on the board
/A7672S/BT_ANT: J4.1, U4.93 (BT_ANT)
/A7672S/GNSS_ANT: J5.1, L2.1, U4.90 (GNSS_ANT)
/A7672S/GNSS_PWRCTL: R24.2, U6.6 (A5)
/A7672S/GNSS_RXD: R22.2, U6.4 (A3)
/A7672S/GNSS_TXD: R23.2, U6.5 (A4)
/A7672S/NETLIGHT: R18.1, U4.52 (NETLIGHT)
/A7672S/RESET: D9.2 (A2), Q2.2 (C), U4.16 (~RESET)
/A7672S/RF_ANT: J1.1, U4.60 (RF_ANT)
/A7672S/SIM_RX: U4.9 (TXD), U6.1 (A1)
/A7672S/SIM_TX: U4.10 (RXD), U6.3 (A2)
/A7672S/USIM_CLK: C24.1, R27.1, U4.32 (USIM1_CLK)
/A7672S/USIM_DATA: C25.1, R28.1, U4.31 (USIM1_DATA)
/A7672S/USIM_RST: C23.1, R26.1, U4.33 (USIM1_RST)
/A7672S/USIM_VDD: C26.2, C27.2, C28.2, D10.5 (K), J7.C1 (VCC), U4.30 (USIM1_VDD)
/A7672S/VDD_1V8: C21.1, C29.1, R21.2, U4.15 (VDD_1V8), U6.2 (V_{CCA}), U6.10 (OE)
ESP_IO21: U6.15 (B5); also elsewhere on the board
ESP_RX1: U6.18 (B2); also elsewhere on the board
ESP_TX1: U6.20 (B1); also elsewhere on the board
GND: C16.2, C17.2, C18.2, C19.2, C20.2, C21.2, C22.2, C23.2, C24.2, C25.2, C26.1, C27.1, C28.1, C29.2, C30.2, D8.1 (A1), D9.1 (A1), D10.2 (A), J1.2, J1.3, J4.2, J4.3, J5.2, J5.3, J7.1 (GND), J7.2 (GND), J7.3 (GND), J7.4 (GND), J7.C5 (GND), J7.C6 (VPP), Q1.3 (E), Q2.3 (E), Q3.2 (E), Q4.2 (E), R8.2, R11.2, R13.2, R19.2, U4.2 (GND_1), U4.17 (GND_1__1), U4.18 (GND_1__2), U4.29 (GND_1__3), U4.39 (GND_1__4), U4.45 (GND_1__5), U4.46 (GND_1__6), U4.54 (GND_1__7), U4.58 (GND_1__8), U4.59 (GND_1__9), U4.61 (GND_1__10), U4.62 (GND_1__11), U4.63 (GND_1__12), U4.64 (GND_1__13), U4.65 (GND_1__14), U4.69 (GND_2), U4.70 (GND_2__1), U4.71 (GND_2__2), U4.72 (GND_2__3), U4.73 (GND_2__4), U4.74 (GND_2__5), U4.75 (GND_2__6), U4.76 (GND_2__7), U4.77 (GND_2__8), U4.78 (GND_2__9), U4.79 (GND_2__10), U4.80 (GND_2__11), U4.81 (GND_2__12), U4.82 (GND_2__13), U4.83 (GND_2__14), U4.84 (GND_3), U4.85 (GND_3__1), U4.86 (GND_3__2), U4.87 (GND_3__3), U4.88 (GND_3__4), U4.89 (GND_3__5), U4.91 (GND_3__6), U4.92 (GND_3__7), U4.94 (GND_3__8), U6.7 (A6), U6.8 (A7), U6.9 (A8), U6.11 (GND), U6.12 (B8), U6.13 (B7), U6.14 (B6), U6.21 (GND); also elsewhere on the board
MRESET: R10.1; also elsewhere on the board
unnamed: D8.2 (A2), Q1.2 (C), U4.1 (~PWRKEY)
unnamed: D11.1 (K), R17.2
unnamed: D12.1 (K), R20.2
unnamed: D10.3 (K), J7.C3 (CLK), R27.2
unnamed: D10.1 (K), J7.C7 (I/O), R28.2
unnamed: D10.4 (K), J7.C2 (RST), R26.2
unnamed: Q1.1 (B), R8.1, R9.2
unnamed: Q2.1 (B), R10.2, R11.1
unnamed: Q3.1 (B), R12.2, R13.1
unnamed: Q3.3 (C), R17.1
unnamed: Q4.1 (B), R18.2, R19.1
unnamed: Q4.3 (C), R20.1
unnamed: R24.1, U4.98 (GNSS_PWRCTL)
unnamed: R22.1, U4.96 (GNSS_RXD)
unnamed: R23.1, U4.95 (GNSS_TXD)
unnamed: R12.1, U4.66 (STATUS)
unnamed: R21.1, U4.97 (1V8_GNSS), U4.116 (GNSS_VBKP)
PWRKEY: R9.1; also elsewhere on the board
RX2: U6.16 (B4); also elsewhere on the board
TX2: U6.17 (B3); also elsewhere on the board

Notes on the sheet:
BLUETOOTH ANTENNA
GNSS ANTENNA
LEVEL SHIFTER
SIM CARD SOCKET
RESET CIRCUIT
LTE ANTENNA
NETWORK INDICATOR LED

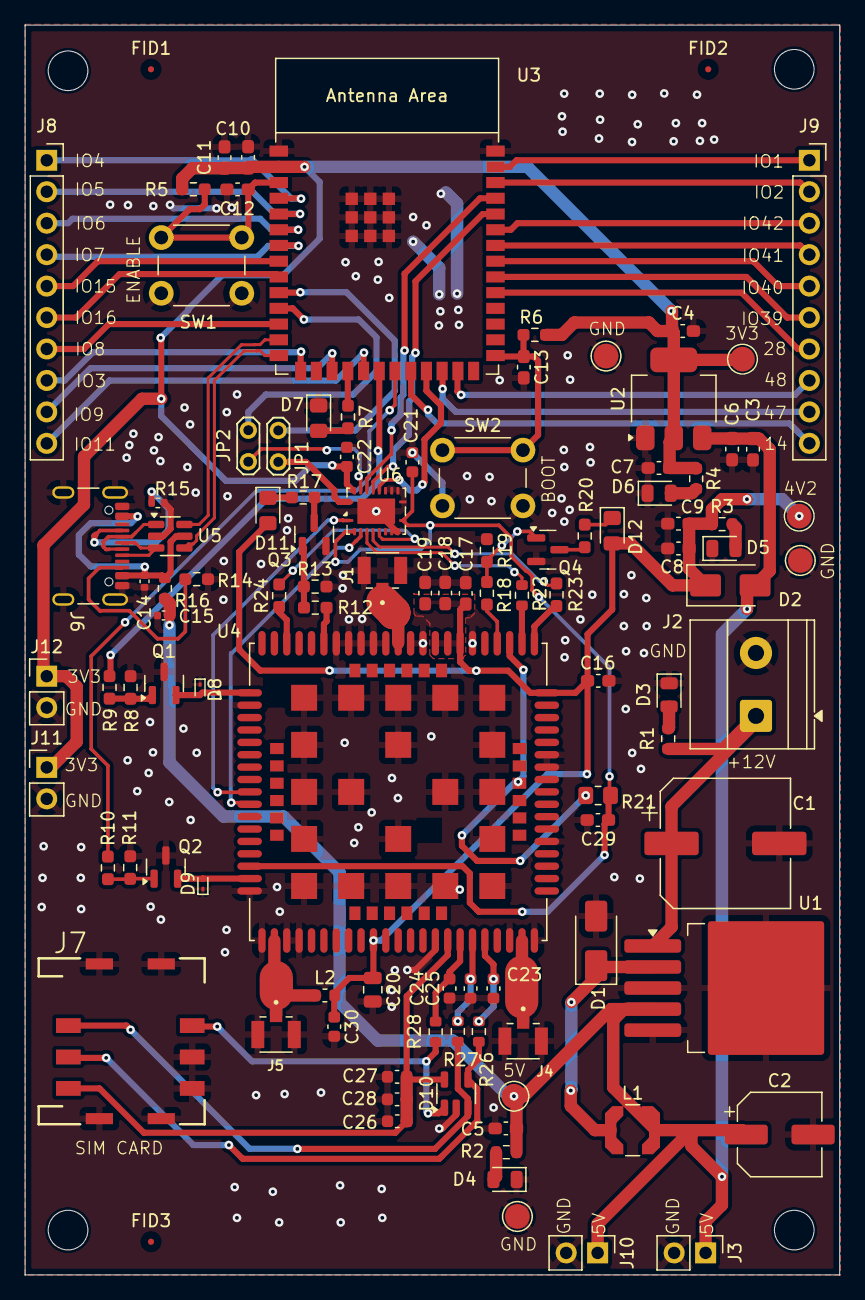
[picture p11: board ESP32S3-A7672S.kicad_pcb from above]

Board: 2 copper layers, 65.8 x 100.9 mm, 110 parts (0 on the bottom side), 82 nets.
